rolfeb/proj-rf-sensor-network/rpi-receiver/eagle/rpi-receiver.pdf

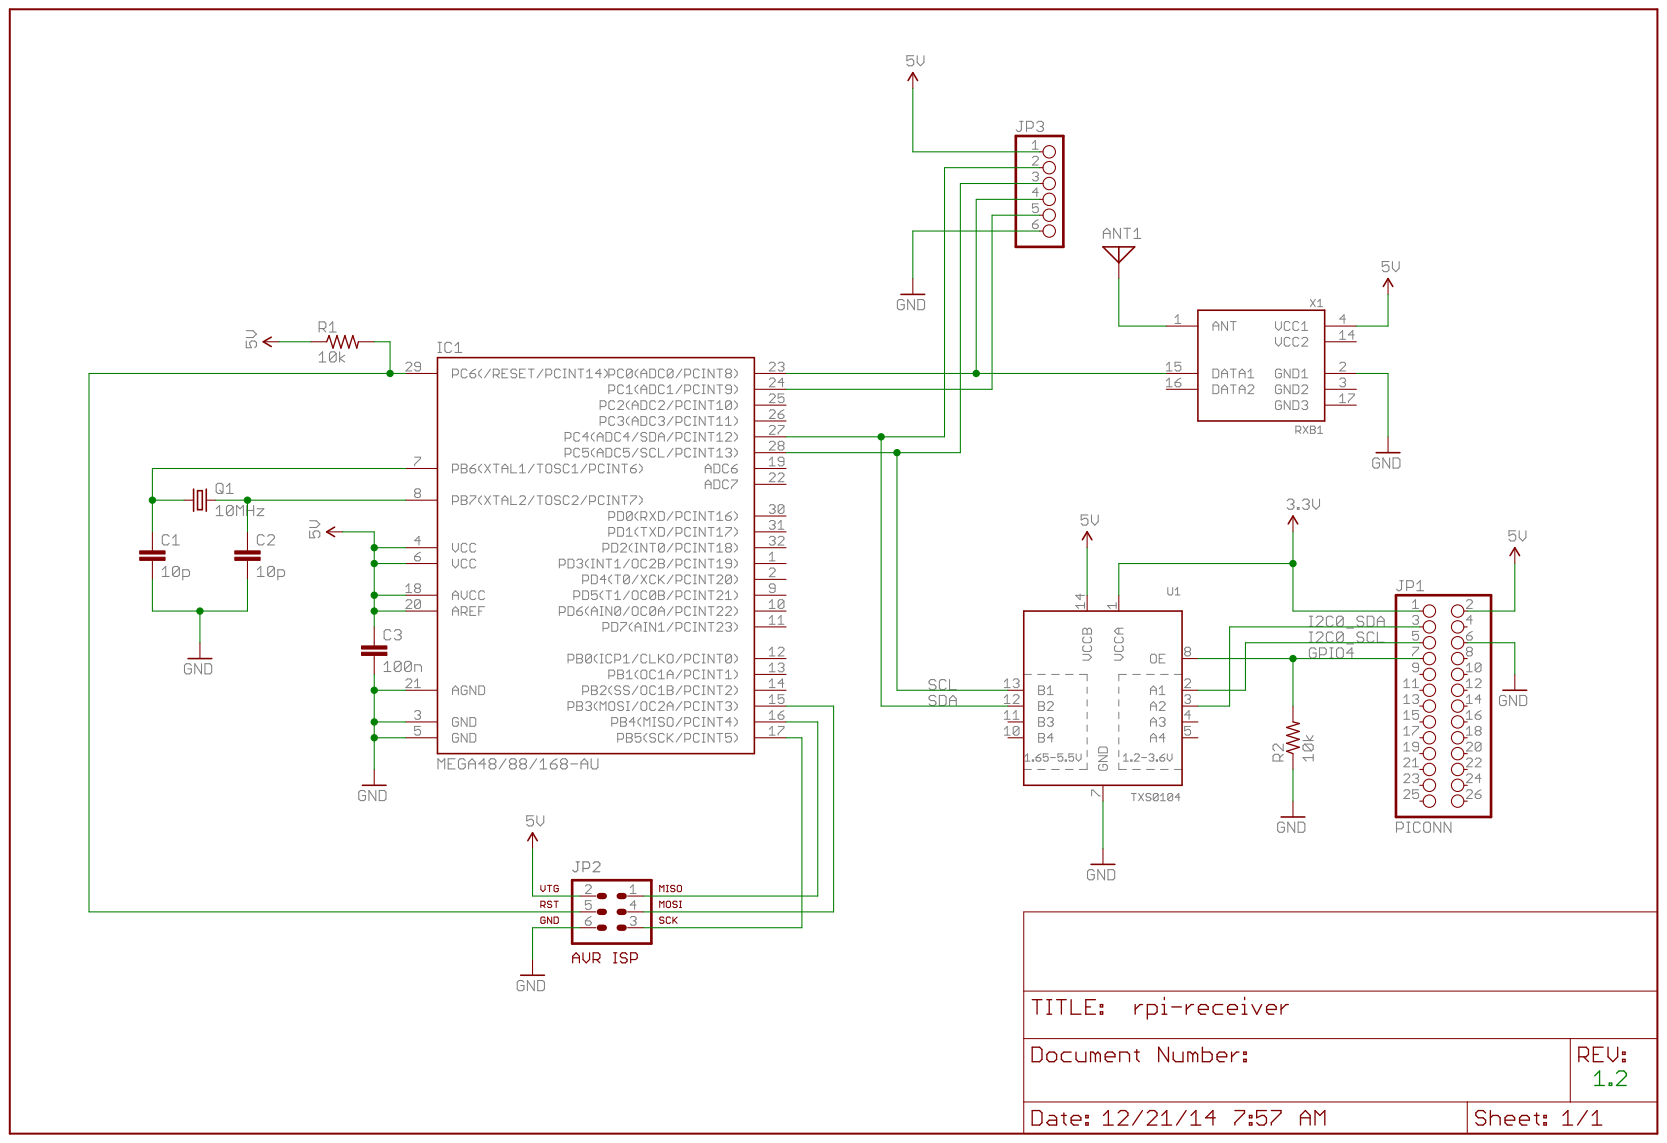
[picture p1: page 1]

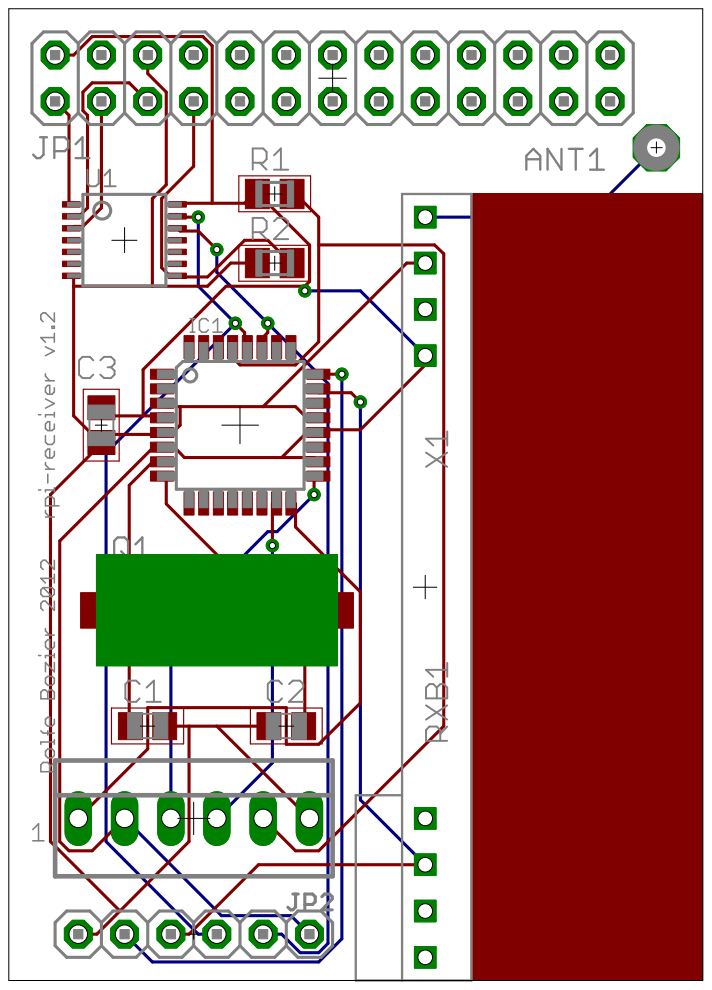
[picture p2: page 2]
