rolfeb/proj-rf-sensor-network/sensor-t/eagle/sensor-t.pdf

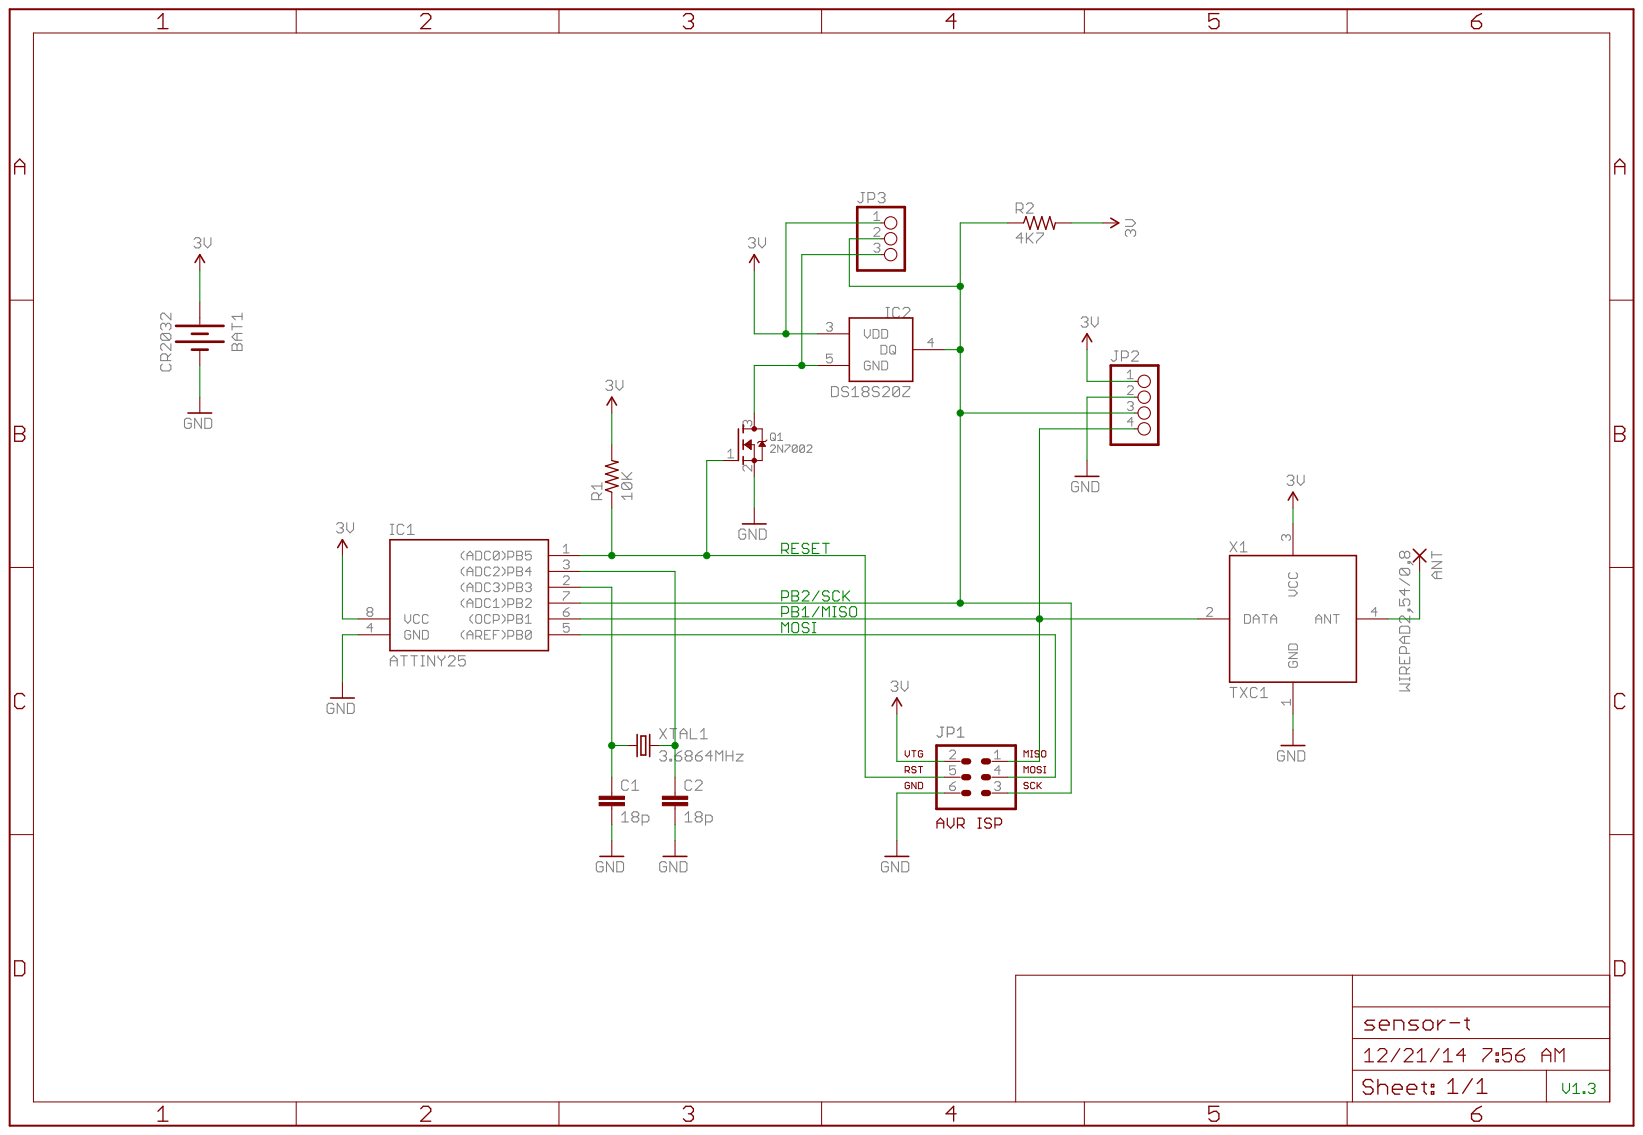
[picture p3: page 1]

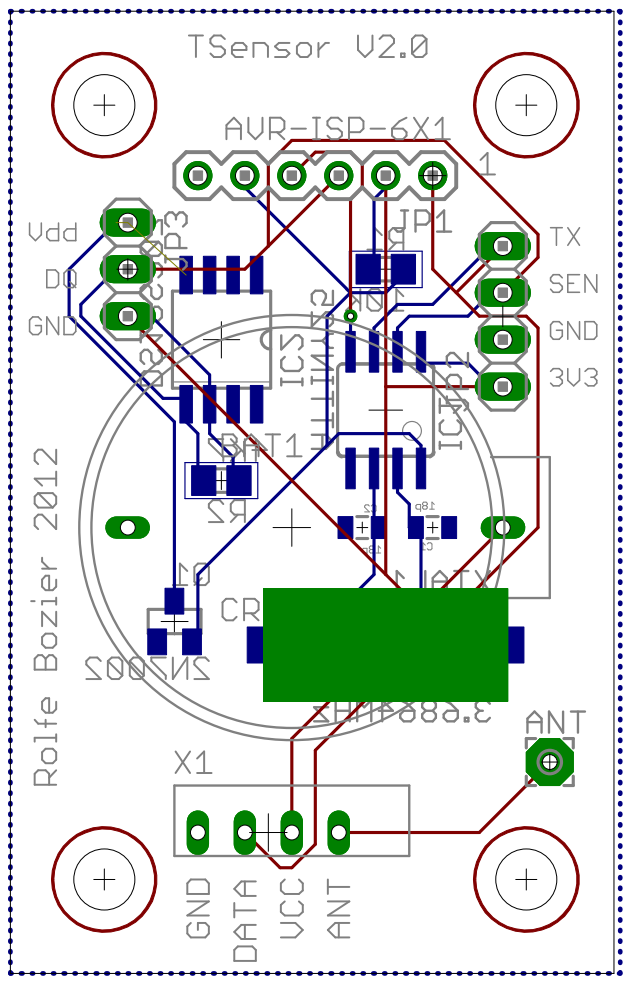
[picture p4: page 2]
