rolfeb/proj-rf-sensor-network/sensor-t/eagle/sensor-t.brd

## EAGLE design sensor-t/eagle/sensor-t.brd (2014-12-20)

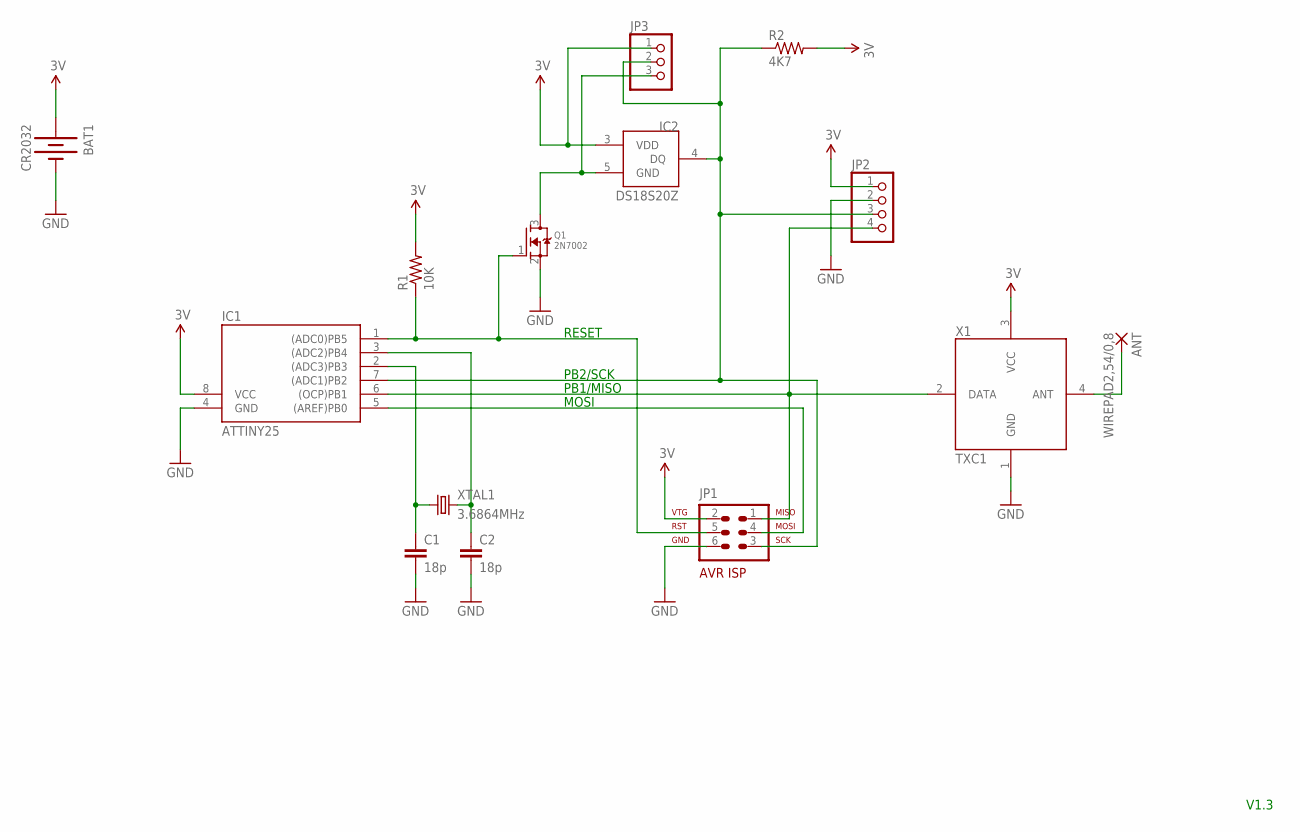
[picture p5: schematic sensor-t.sch]

Parts:
ANT: WIREPAD2,54/0,8; 2,54/0,8
BAT1: CR2032; BATTCON_CELL_20MM
C1, C2: 18p; 0805
IC1: ATTINY25; SOIC8
IC2: DS18S20Z; SO08-208
JP1: AVR-ISP-6X1; 1X06
JP2: PINHD-1X4; 1X04
JP3: PINHD-1X3; 1X03
Q1: 2N7002; SOT23
R1: 10K; M0805
R2: 4K7; M0805
X1: TXC1
XTAL1: 3.6864MHz; HC49UP

Connections:
3.3V: BAT1.+VE (+), IC1.8 (VCC), IC2.3 (VDD), JP1.2, JP2.1, JP3.1, R1.2, R2.2, X1.3 (VCC)
GND: BAT1.-VE (-), C1.2, C2.2, IC1.4 (GND), JP1.6, JP2.2, Q1.2 (S), X1.1 (GND)
unnamed: IC1.6 ((OCP)PB1), JP1.1, JP2.4, X1.2 (DATA)
unnamed: IC1.5 ((AREF)PB0), JP1.4
unnamed: ANT.1, X1.4 (ANT)
unnamed: IC1.1 ((ADC0)PB5), JP1.5, Q1.1 (G), R1.1
unnamed: C1.1, IC1.2 ((ADC3)PB3), XTAL1.1
unnamed: C2.1, IC1.3 ((ADC2)PB4), XTAL1.2
unnamed: IC1.7 ((ADC1)PB2), IC2.4 (DQ), JP1.3, JP2.3, JP3.2, R2.1
unnamed: IC2.5 (GND), JP3.3, Q1.3 (D)

Notes on the sheet:
V1.3
RESET
PB2/SCK
PB1/MISO
MOSI

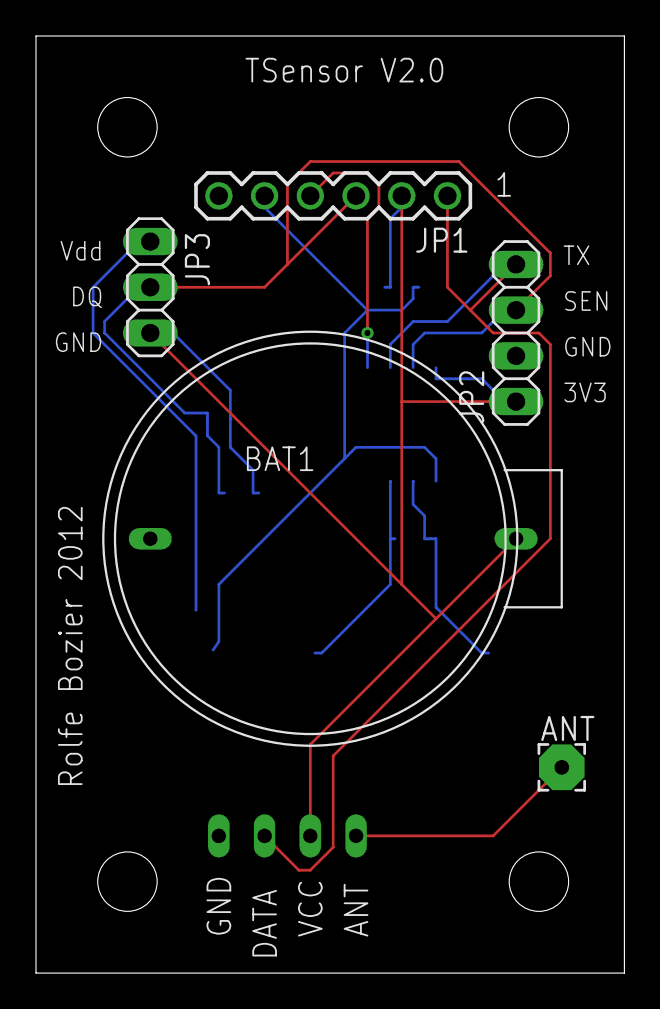
[picture p6: board sensor-t.brd from above]

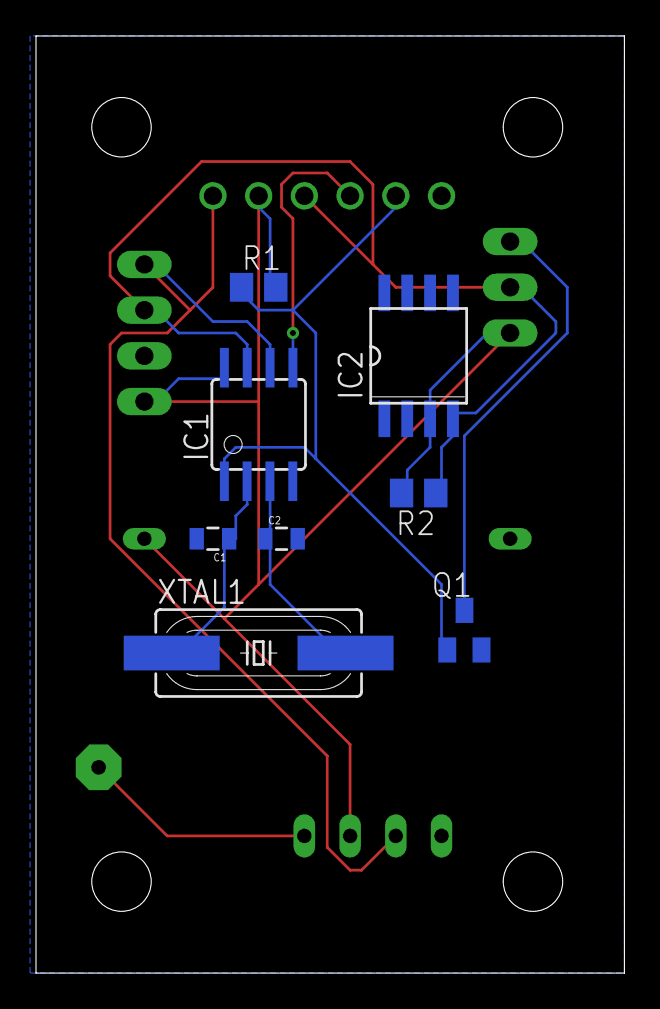
[picture p7: board sensor-t.brd from below]

Board: 2 copper layers, 32.7 x 52.1 mm, 18 parts (8 on the bottom side), 10 nets.

Other parts of the board:
U$1, U$2, U$3, U$4: STAND-OFF
