rolfeb/proj-rf-sensor-network/rpi-receiver/eagle/rpi-receiver.brd

## EAGLE design rpi-receiver/eagle/rpi-receiver.brd (2014-12-20)

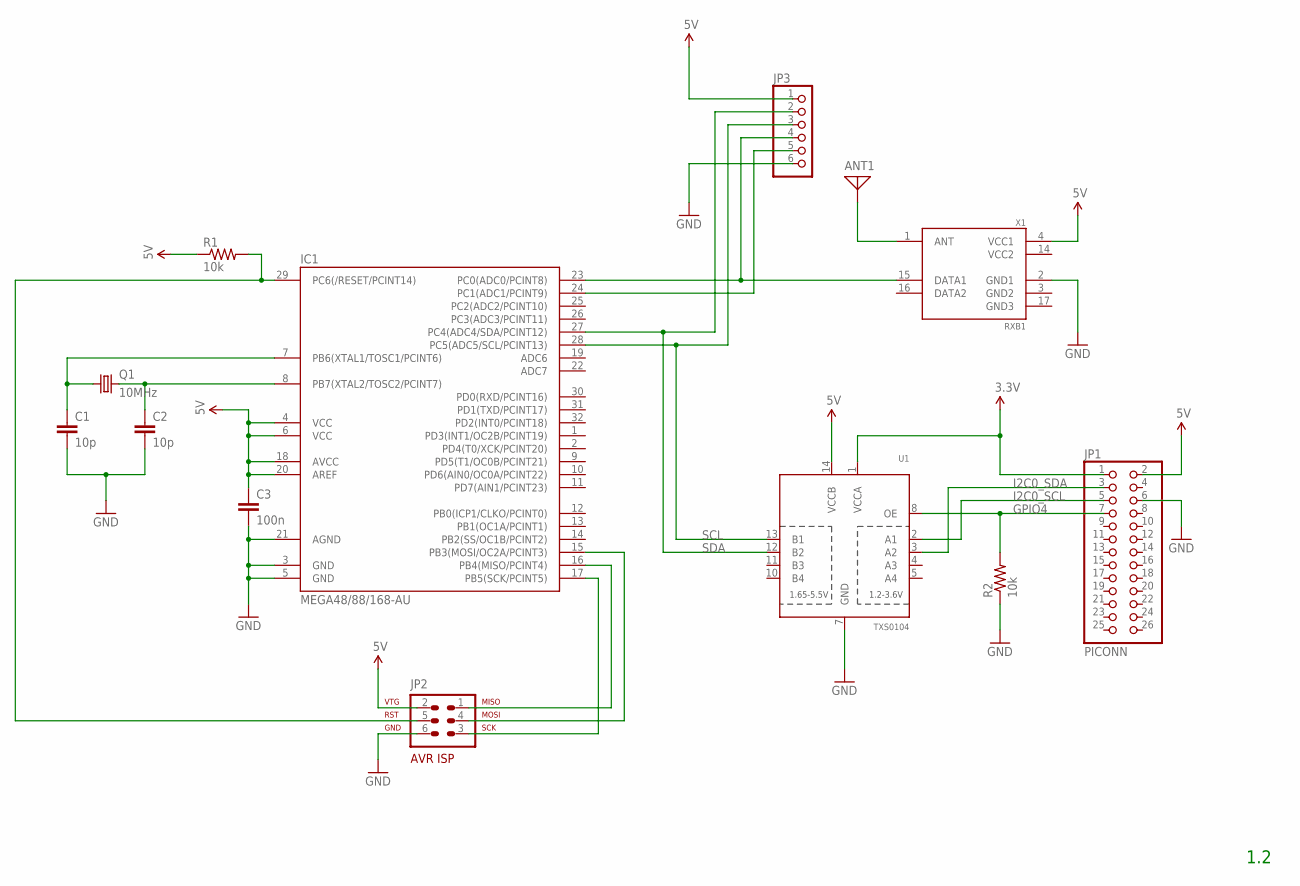
[picture p8: schematic rpi-receiver.sch]

Parts:
ANT1: ANTENNA; PAD-01
C1, C2: 10p; C0805
C3: 100n; C0805
IC1: MEGA48/88/168-AU; TQFP32-08
JP1: PICONN; 2X13
JP2: AVR-ISP-6POL-HDR; 22-23-2061
JP3: PINHD-1X6; 1X06
Q1: 10MHz; HC49UP
R1, R2: 10k; M0805
U1: TXS0104; TSSOP14
X1: RXB1

Connections:
3.3V: JP1.1, U1.1 (VCCA)
5V: C3.1, IC1.4 (VCC), IC1.6 (VCC), IC1.18 (AVCC), IC1.20 (AREF), JP1.2, JP2.2, JP3.1, R1.1, U1.14 (VCCB), X1.4 (VCC1)
GND: C1.2, C2.2, C3.2, IC1.3 (GND), IC1.5 (GND), IC1.21 (AGND), JP1.6, JP2.6, JP3.6, R2.1, U1.7 (GND), X1.2 (GND1)
GND2: X1.3 (GND2)
GND3: X1.17 (GND3)
GPIO4: JP1.7, R2.2, U1.8 (OE)
I2C0_SCL: JP1.5, U1.2 (A1)
I2C0_SDA: JP1.3, U1.3 (A2)
unnamed: C2.1, IC1.8 (PB7(XTAL2/TOSC2/PCINT7)), Q1.2
unnamed: C1.1, IC1.7 (PB6(XTAL1/TOSC1/PCINT6)), Q1.1
unnamed: IC1.16 (PB4(MISO/PCINT4)), JP2.1
unnamed: IC1.15 (PB3(MOSI/OC2A/PCINT3)), JP2.4
unnamed: ANT1.1, X1.1 (ANT)
unnamed: IC1.29 (PC6(/RESET/PCINT14)), JP2.5, R1.2
unnamed: IC1.17 (PB5(SCK/PCINT5)), JP2.3
unnamed: IC1.24 (PC1(ADC1/PCINT9)), JP3.5
unnamed: IC1.23 (PC0(ADC0/PCINT8)), JP3.4, X1.15 (DATA1)
SCL: IC1.28 (PC5(ADC5/SCL/PCINT13)), JP3.3, U1.13 (B1)
SDA: IC1.27 (PC4(ADC4/SDA/PCINT12)), JP3.2, U1.12 (B2)
VCC2: X1.14 (VCC2)

Notes on the sheet:
1.2

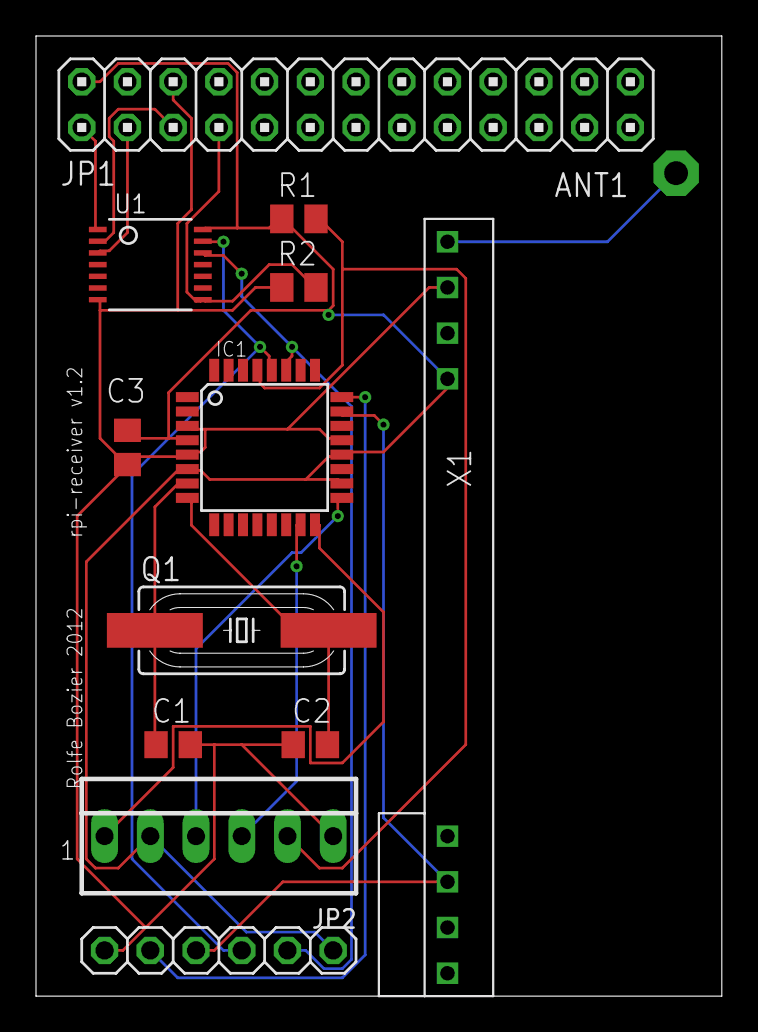
[picture p9: board rpi-receiver.brd from above]

Board: 2 copper layers, 38.1 x 53.3 mm, 13 parts (0 on the bottom side), 17 nets.
