rolfeb/proj-rf-sensor-network/(commit log)

2014-12-20 Initial commit.
    [rpi-receiver.brd, rpi-receiver.sch, sensor-t.brd, sensor-t.sch]
2016-03-10 Added new sensor for battery voltage. Measure the battery voltage every hour and include in message.
2016-03-13 Added sensor daemon and database creation scripts.
2016-03-13 Added a brief note about the sensord daemon.
